tamergrlli/32S_BMS/docs/linkedin_square.png

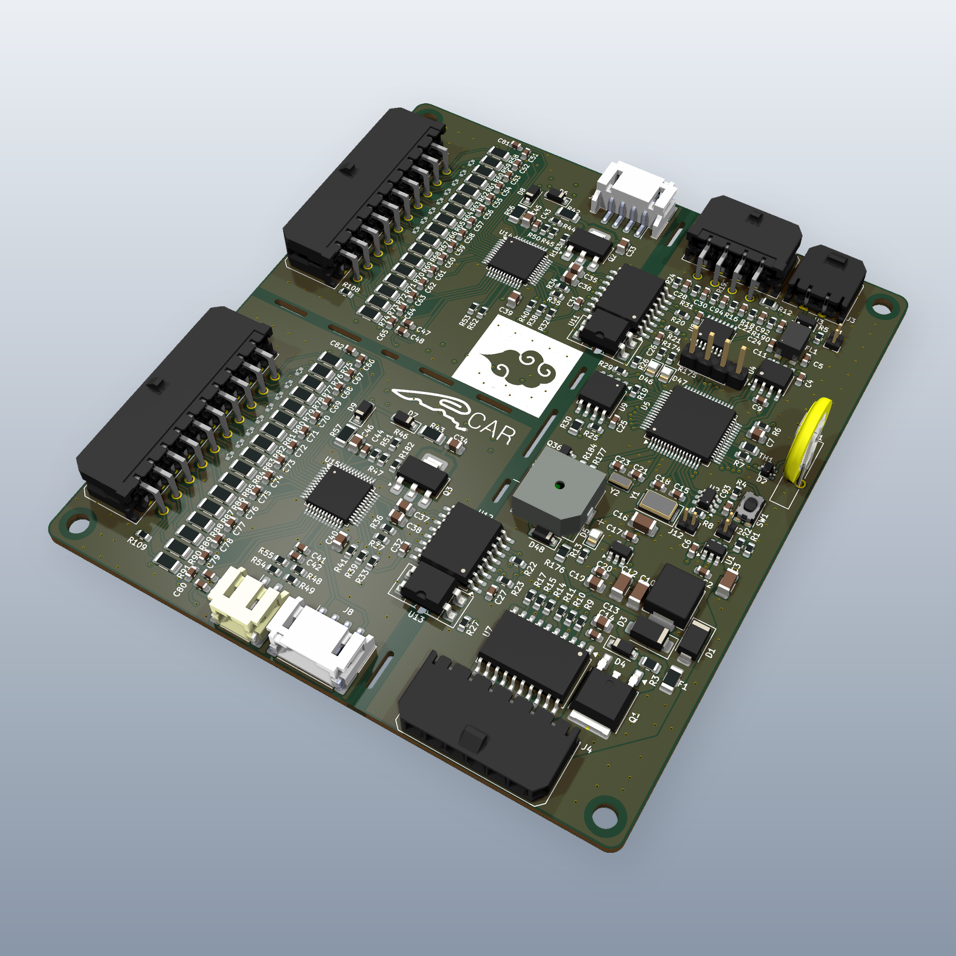
docs/linkedin_square.png
