tamergrlli/32S_BMS/32s_bms_lib/3dmodels/ACT45B_TDK.step

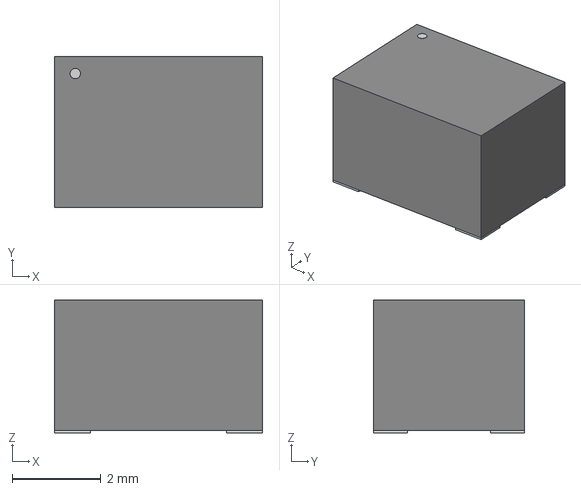
[picture p6: CAD file, 2026-11-05]
32s_bms_lib/3dmodels/ACT45B_TDK.step
4.70 x 3.40 x 3.00 mm
