tamergrlli/32S_BMS/32s_bms_lib/3dmodels/S2B-PH-SM4-TB.step

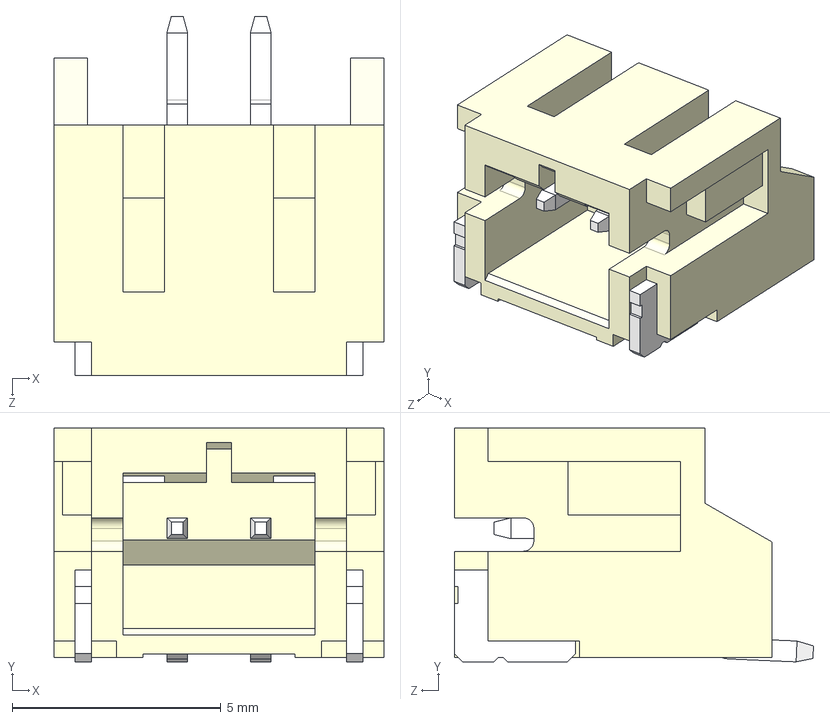
[picture p7: CAD file, 2026-11-05]
32s_bms_lib/3dmodels/S2B-PH-SM4-TB.step
7.90 x 5.60 x 8.60 mm
