tamergrlli/32S_BMS/32s_bms_lib/3dmodels/CR1220-VCN.stp

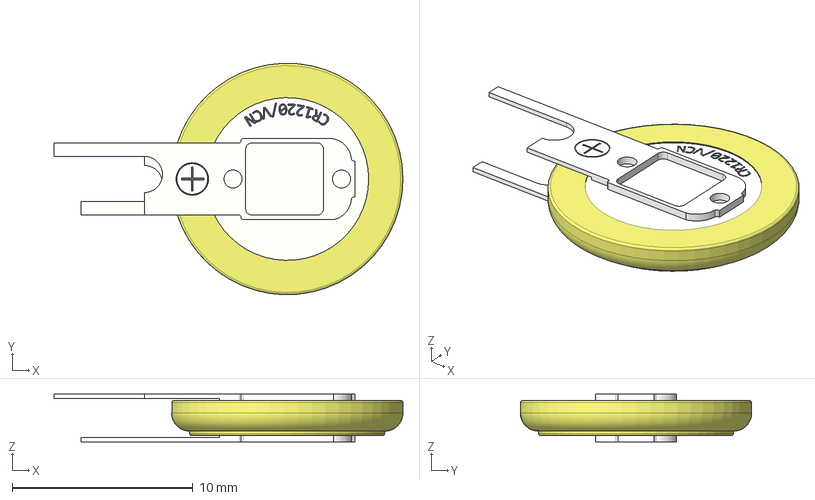
[picture p8: CAD file, 2026-11-05]
32s_bms_lib/3dmodels/CR1220-VCN.stp
19.3 x 12.8 x 2.65 mm
