tamergrlli/32S_BMS/32s_bms_lib/3dmodels/SMI-1027-T-5V-R.step

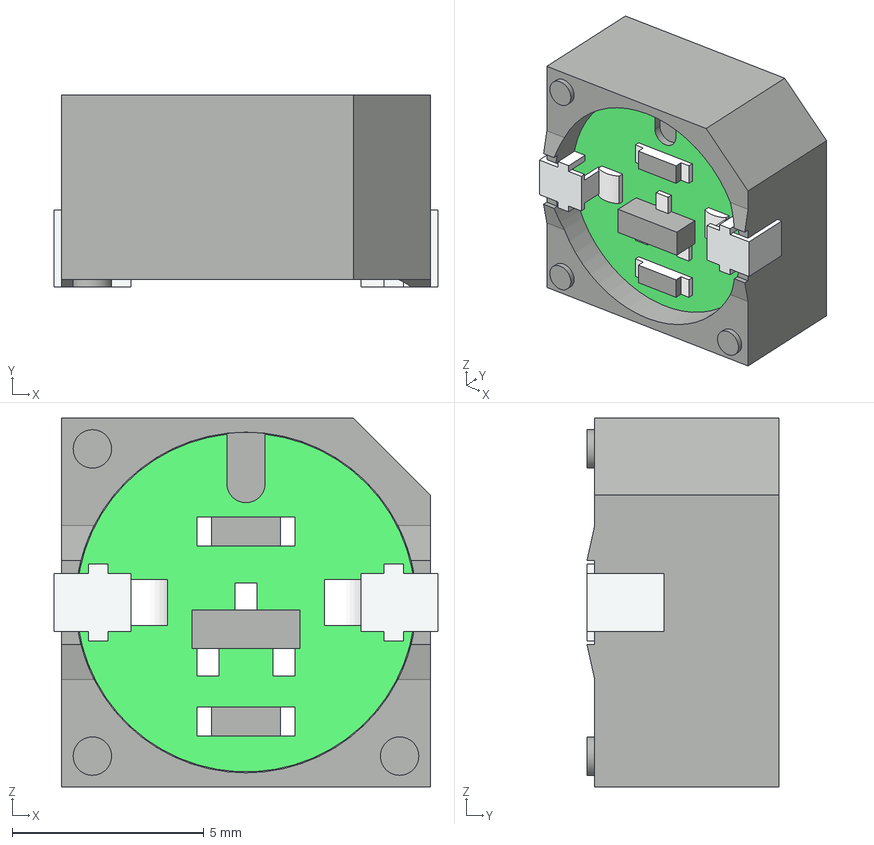
[picture p9: CAD file, 2026-11-05]
32s_bms_lib/3dmodels/SMI-1027-T-5V-R.step
10.0 x 5.00 x 9.60 mm
