tamergrlli/32S_BMS/32s_bms_lib/3dmodels/S4B-PH-SM4-TB.step

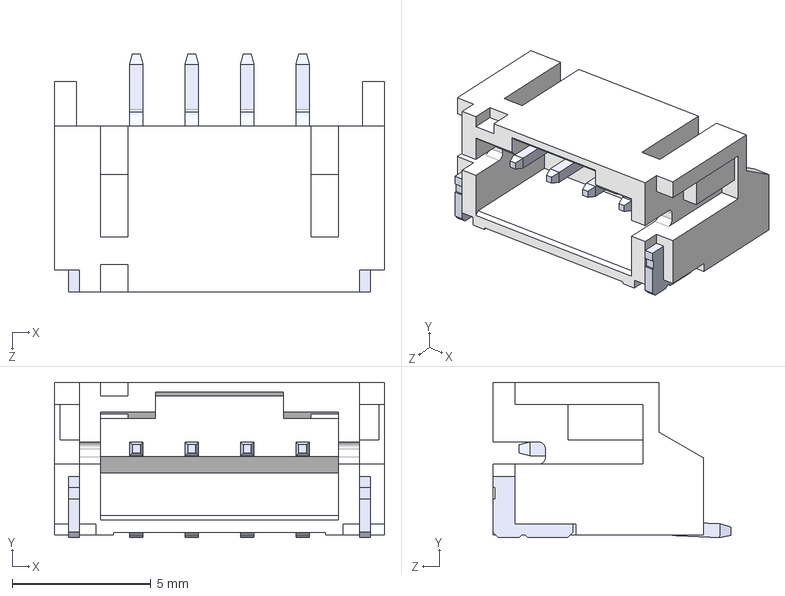
[picture p10: CAD file, 2026-11-05]
32s_bms_lib/3dmodels/S4B-PH-SM4-TB.step
11.9 x 5.60 x 8.60 mm
