tamergrlli/32S_BMS/32s_bms_lib/3dmodels/436501000.stp

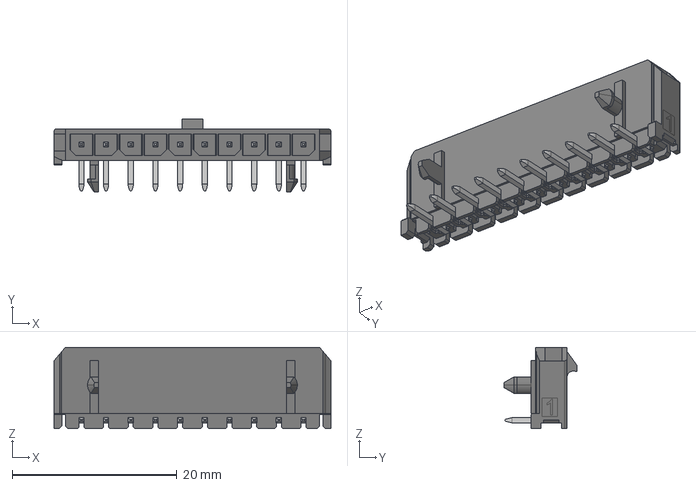
[picture p11: CAD file, 2026-11-05]
32s_bms_lib/3dmodels/436501000.stp
33.7 x 8.87 x 9.90 mm
