tamergrlli/32S_BMS/32s_bms_lib/3dmodels/436500600.stp

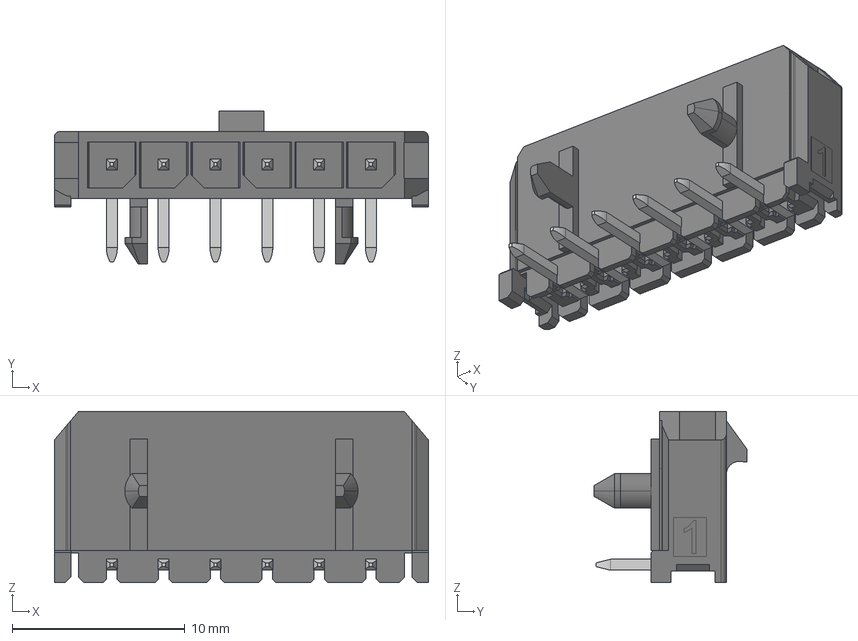
[picture p12: CAD file, 2026-11-05]
32s_bms_lib/3dmodels/436500600.stp
21.6 x 8.87 x 9.90 mm
