tamergrlli/32S_BMS/32s_bms_lib/3dmodels/430452000.stp

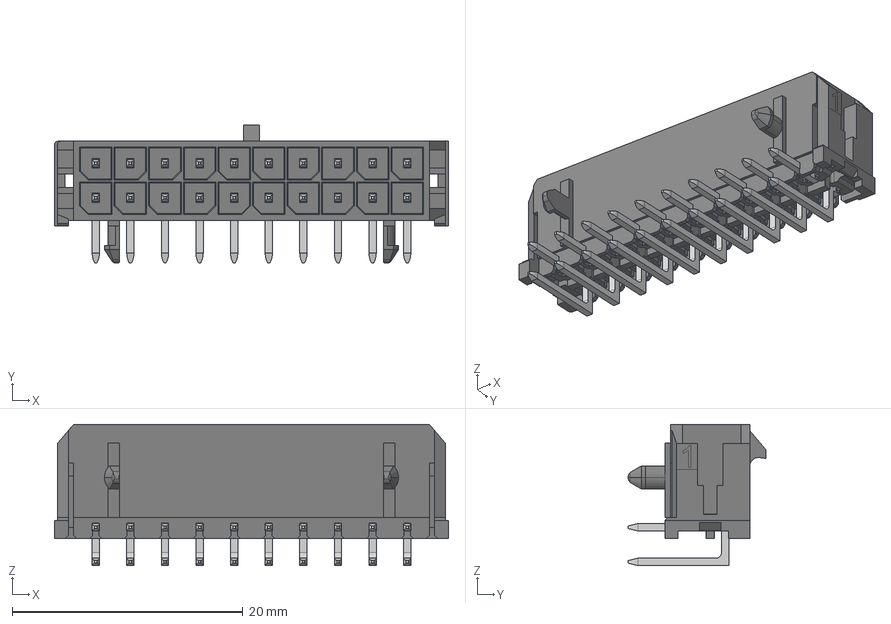
[picture p13: CAD file, 2026-11-05]
32s_bms_lib/3dmodels/430452000.stp
34.2 x 12.0 x 12.2 mm
