tamergrlli/32S_BMS/32s_bms_lib/3dmodels/430450800.stp

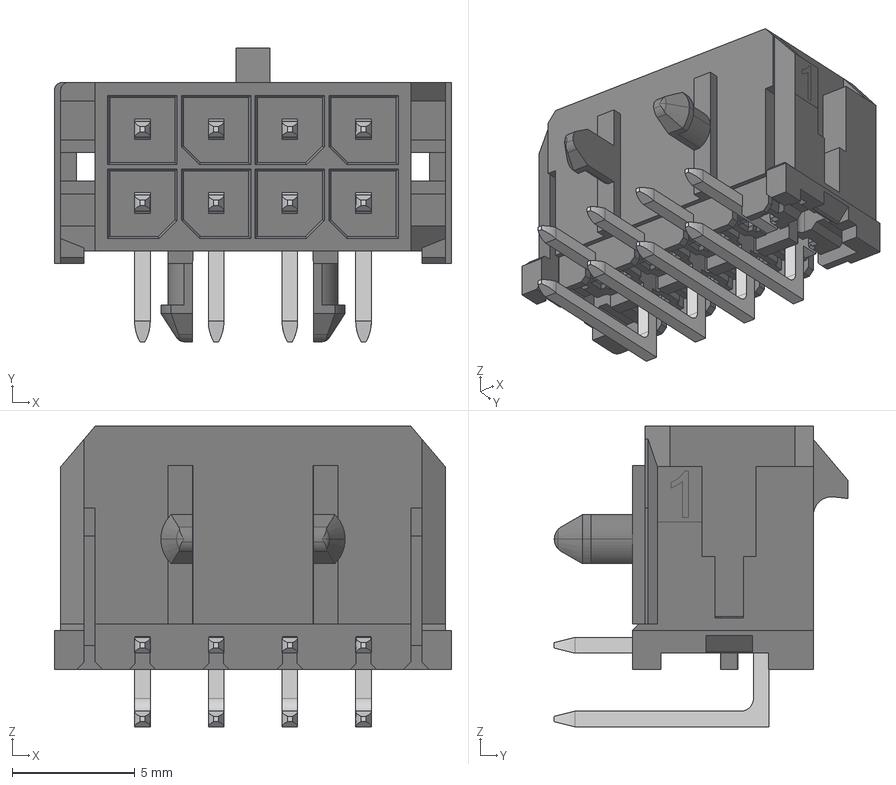
[picture p14: CAD file, 2026-11-05]
32s_bms_lib/3dmodels/430450800.stp
16.2 x 12.0 x 12.2 mm
