tamergrlli/32S_BMS/32s_bms_lib/3dmodels/436500200.stp

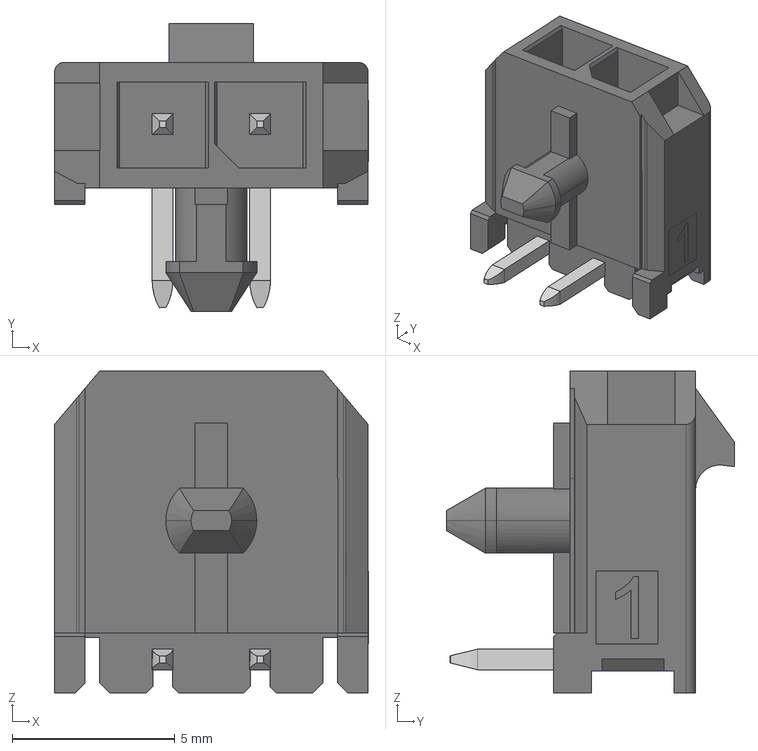
[picture p15: CAD file, 2026-11-05]
32s_bms_lib/3dmodels/436500200.stp
9.66 x 8.87 x 9.90 mm
