tamergrlli/32S_BMS/32s_bms/32s_bms.kicad_pcb

## KiCad design 32s_bms/32s_bms.kicad_pcb (2026-11-05)

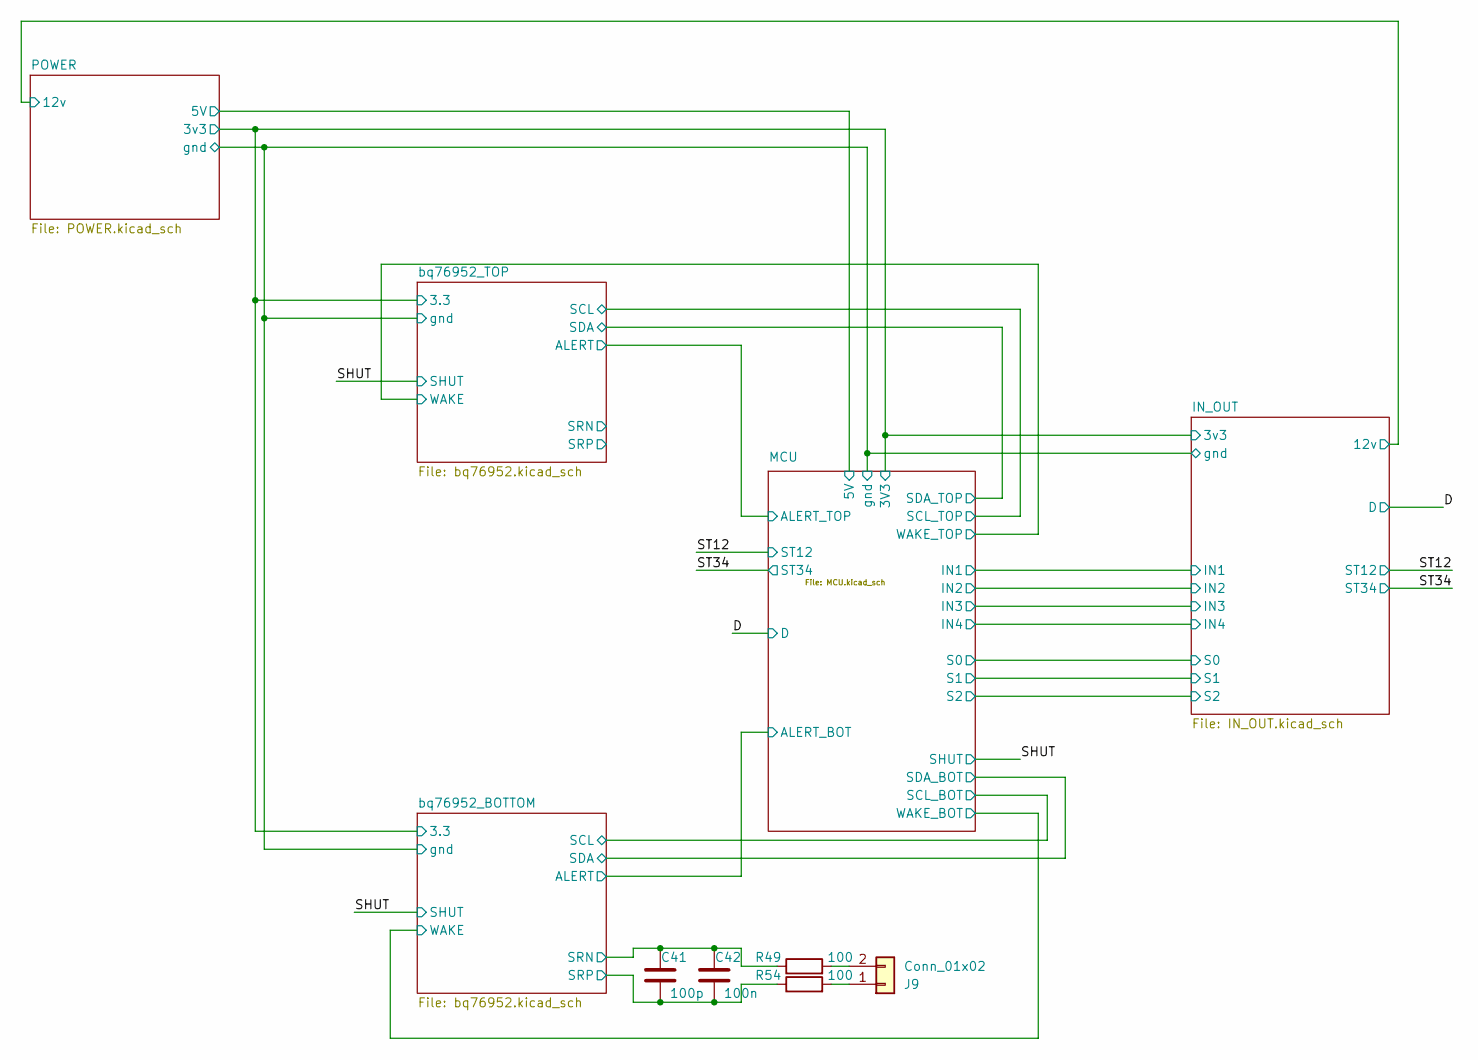
[picture p27: schematic 32s_bms.kicad_sch, 32S BMS]

Parts:
C41: 100p; C_0603_1608Metric
C42: 100n; C_0603_1608Metric
J9: Conn_01x02; JST_PH_S2B-PH-SM4-TB_1x02-1MP_P2.00mm_Horizontal
R49, R54: 100; R_0603_1608Metric

Connections:
/bq76952_BOTTOM/SRN: C41.2, C42.2, R49.1; also elsewhere on the board
/bq76952_BOTTOM/SRP: C41.1, C42.1, R54.1; also elsewhere on the board
unnamed: J9.1, R54.2
unnamed: J9.2, R49.2

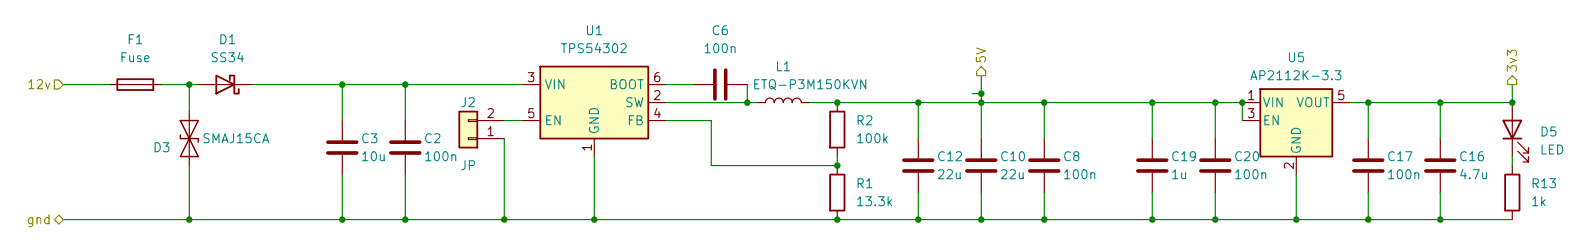
[picture p28: schematic POWER.kicad_sch]

Parts:
C2, C6, C8, C17, C20: 100n; C_0603_1608Metric
C3: 10u; C_1206_3216Metric
C10, C12: 22u; C_1206_3216Metric
C16: 4.7u; C_1206_3216Metric
C19: 1u; C_0805_2012Metric
D1: SS34; D_SMA
D3: SMAJ15CA; D_SMA
D5: LED; LED_0805_2012Metric
F1: Fuse; Fuse_1206_3216Metric
J2: JP; PinHeader_1x02_P1.27mm_Vertical
L1: ETQ-P3M150KVN; L_Panasonic_PCC-M0630M
R1: 13.3k; R_0603_1608Metric
R2: 100k; R_0603_1608Metric
R13: 1k; R_0603_1608Metric
U1: TPS54302; SOT-23-6
U5: AP2112K-3.3; SOT-23-5

Connections:
/IN_OUT/3v3: C16.1, C17.2, D5.2 (A), U5.5 (VOUT); also elsewhere on the board
/IN_OUT/12v: F1.1; also elsewhere on the board
/IN_OUT/gnd: C2.1, C3.2, C8.1, C10.2, C12.2, C16.2, C17.1, C19.2, C20.1, D3.2 (A2), J2.1, R1.2, R13.2, U1.1 (GND), U5.2 (GND); also elsewhere on the board
/MCU/5V: C8.2, C10.1, C12.1, C19.1, C20.2, L1.2, R2.1, U5.1 (VIN), U5.3 (EN); also elsewhere on the board
unnamed: D1.2 (A), D3.1 (A1), F1.2
unnamed: C2.2, C3.1, D1.1 (K), U1.3 (VIN)
unnamed: D5.1 (K), R13.1
unnamed: J2.2, U1.5 (EN)
unnamed: C6.1, U1.6 (BOOT)
unnamed: R1.1, R2.2, U1.4 (FB)
unnamed: C6.2, L1.1, U1.2 (SW)

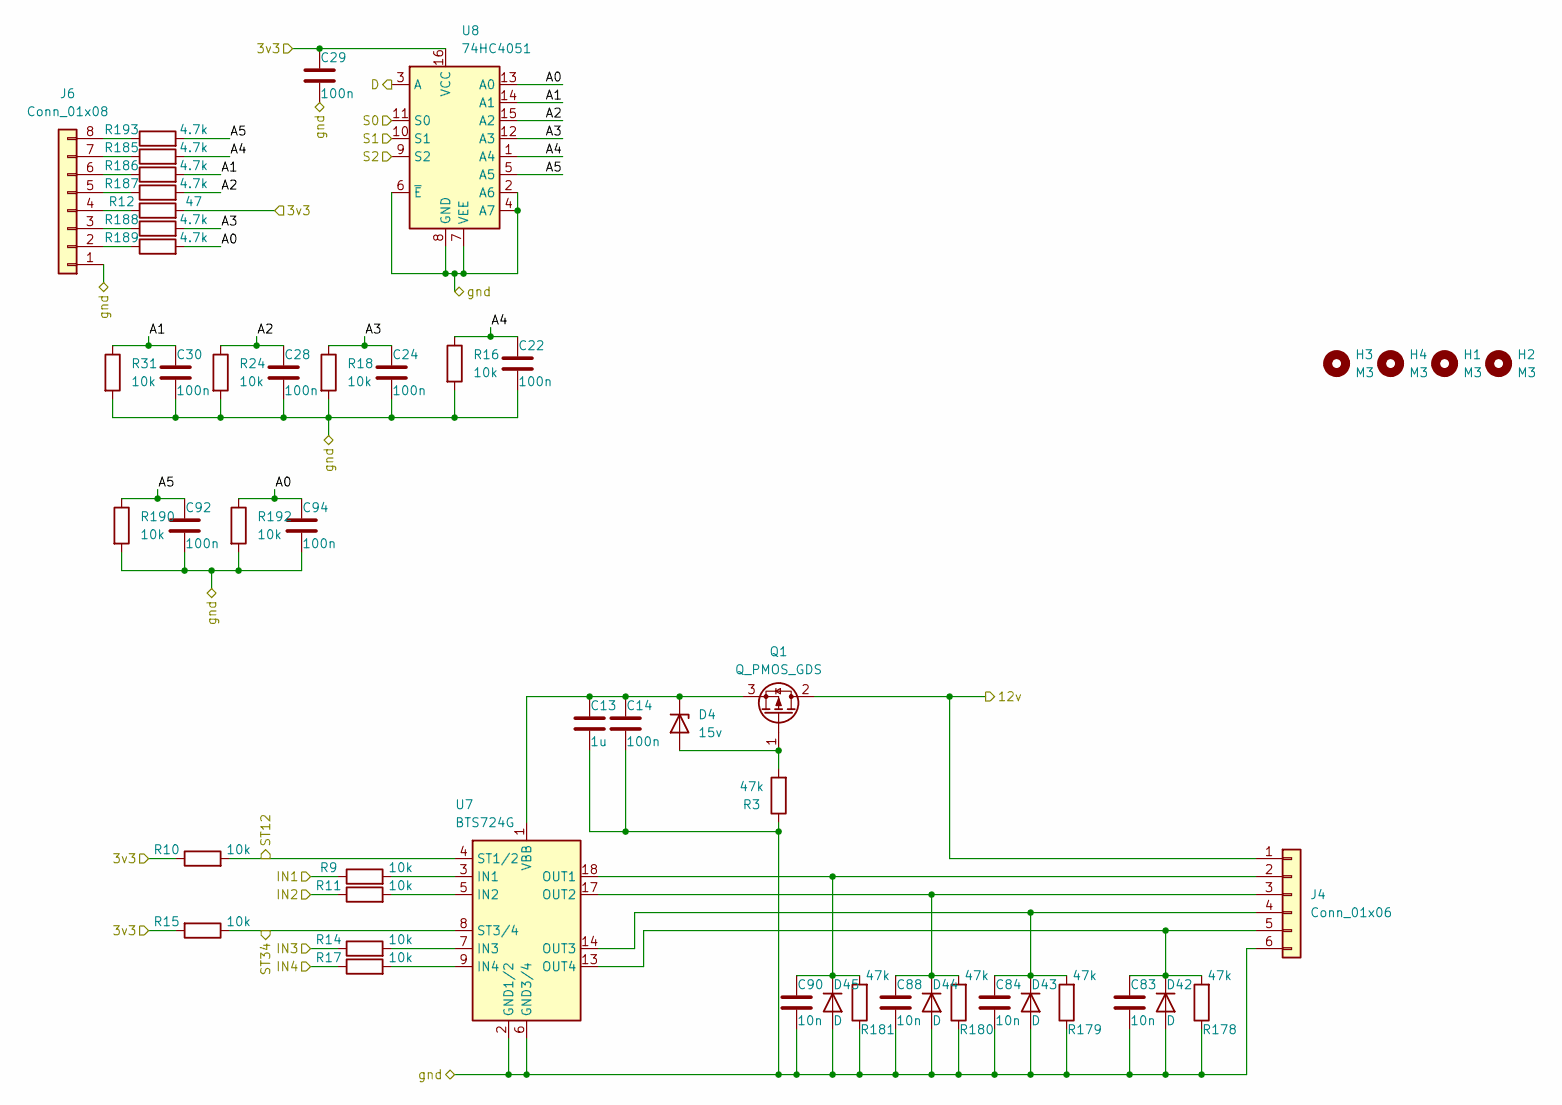
[picture p29: schematic IN_OUT.kicad_sch]

Parts:
C13: 1u; C_0805_2012Metric
C14, C22, C24, C28, C29, C30, C92, C94: 100n; C_0603_1608Metric
C83, C84, C88, C90: 10n; C_0805_2012Metric
D4: 15v; D_SOD-123
D42, D43, D44, D45: D; D_SOD-123
H1, H2, H3, H4: M3; MountingHole_3.2mm_M3
J4: Conn_01x06; Molex_Micro-Fit_3.0_43650-0600_1x06_P3.00mm_Horizontal
J6: Conn_01x08; Molex_Micro-Fit_3.0_43045-0800_2x04_P3.00mm_Horizontal
Q1: Q_PMOS_GDS; TO-252-2
R3, R178, R179, R180, R181: 47k; R_0805_2012Metric
R9, R10, R11, R14, R15, R16, R17, R18, R24, R31, R190, R192: 10k; R_0603_1608Metric
R12: 47; R_0805_2012Metric
R185, R186, R187, R188, R189, R193: 4.7k; R_0603_1608Metric
U7: BTS724G; Infineon_SOIC-20W_7.6x12.8mm_P1.27mm
U8: 74HC4051; TSSOP-16_4.4x5mm_P0.65mm

Connections:
/D: U8.3 (A); also elsewhere on the board
/IN_OUT/3v3: C29.1, R10.1, R12.2, R15.2, U8.16 (VCC); also elsewhere on the board
/IN_OUT/12v: J4.1, Q1.2 (D); also elsewhere on the board
/IN_OUT/A0: C94.1, R189.2, R192.1, U8.13 (A0)
/IN_OUT/A1: C30.1, R31.1, R186.2, U8.14 (A1)
/IN_OUT/A2: C28.1, R24.1, R187.2, U8.15 (A2)
/IN_OUT/A3: C24.1, R18.1, R188.2, U8.12 (A3)
/IN_OUT/A4: C22.1, R16.1, R185.2, U8.1 (A4)
/IN_OUT/A5: C92.1, R190.1, R193.2, U8.5 (A5)
/IN_OUT/IN1: R9.1; also elsewhere on the board
/IN_OUT/IN2: R11.1; also elsewhere on the board
/IN_OUT/IN3: R14.1; also elsewhere on the board
/IN_OUT/IN4: R17.1; also elsewhere on the board
/IN_OUT/S0: U8.11 (S0); also elsewhere on the board
/IN_OUT/S1: U8.10 (S1); also elsewhere on the board
/IN_OUT/S2: U8.9 (S2); also elsewhere on the board
/IN_OUT/gnd: C13.2, C14.2, C22.2, C24.2, C28.2, C29.2, C30.2, C83.2, C84.2, C88.2, C90.2, C92.2, C94.2, D42.2 (A), D43.2 (A), D44.2 (A), D45.2 (A), J4.6, J6.1, R3.1, R16.2, R18.2, R24.2, R31.2, R178.1, R179.1, R180.1, R181.1, R190.2, R192.2, U7.2 (GND1/2), U7.6 (GND3/4), U8.2 (A6), U8.4 (A7), U8.6 (~E), U8.7 (VEE), U8.8 (GND); also elsewhere on the board
/ST12: R10.2, U7.4 (ST1/2); also elsewhere on the board
/ST34: R15.1, U7.8 (ST3/4); also elsewhere on the board
unnamed: D4.2 (A), Q1.1 (G), R3.2
unnamed: C13.1, C14.1, D4.1 (K), Q1.3 (S), U7.1 (VBB), U7.10 (VBB), U7.11 (VBB), U7.12 (VBB), U7.15 (VBB), U7.16 (VBB), U7.19 (VBB), U7.20 (VBB)
unnamed: C83.1, D42.1 (K), J4.5, R178.2, U7.13 (OUT4)
unnamed: C84.1, D43.1 (K), J4.4, R179.2, U7.14 (OUT3)
unnamed: C88.1, D44.1 (K), J4.3, R180.2, U7.17 (OUT2)
unnamed: C90.1, D45.1 (K), J4.2, R181.2, U7.18 (OUT1)
unnamed: J6.2, R189.1
unnamed: J6.3, R188.1
unnamed: J6.4, R12.1
unnamed: J6.5, R187.1
unnamed: J6.6, R186.1
unnamed: J6.7, R185.1
unnamed: J6.8, R193.1
unnamed: R9.2, U7.3 (IN1)
unnamed: R11.2, U7.5 (IN2)
unnamed: R14.2, U7.7 (IN3)
unnamed: R17.2, U7.9 (IN4)

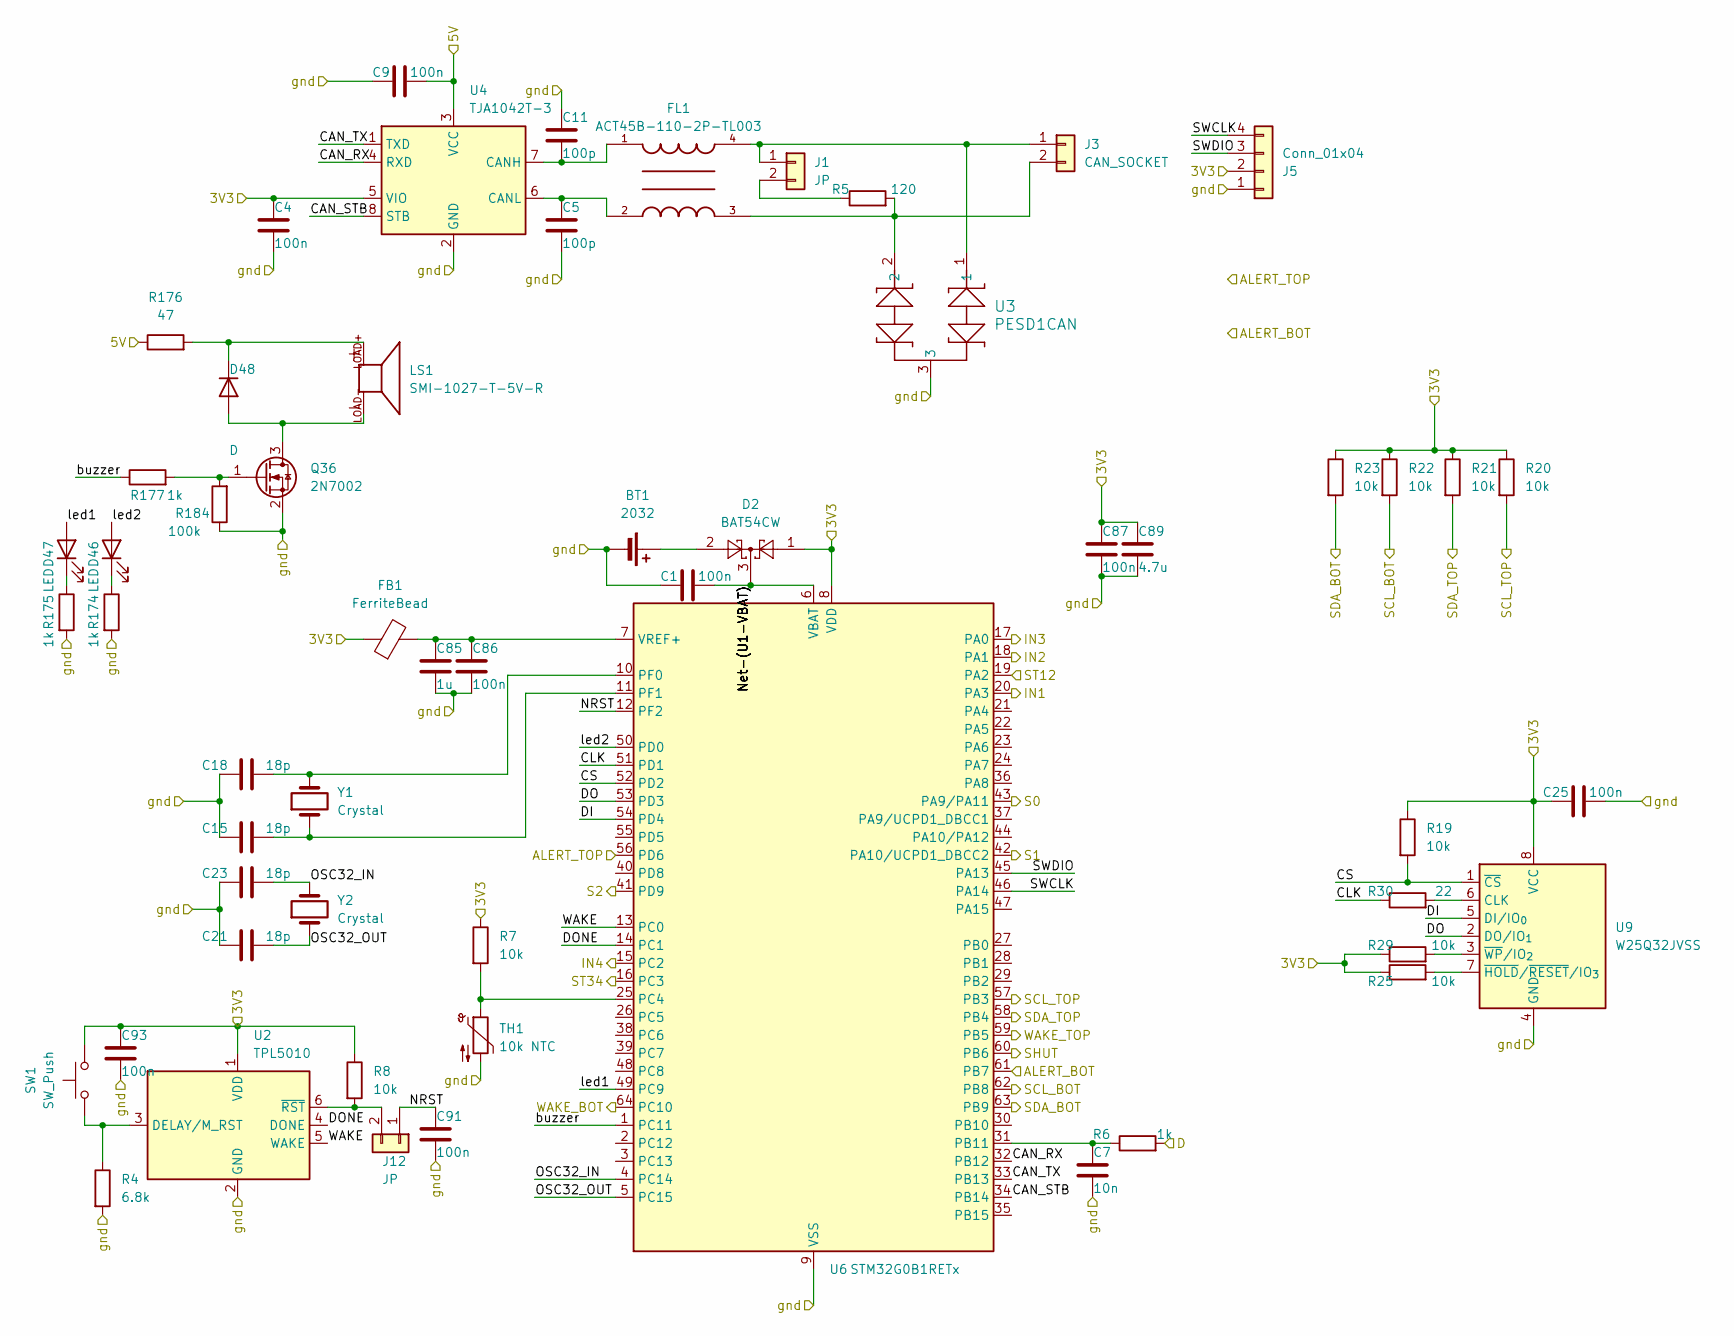
[picture p30: schematic MCU.kicad_sch]

Parts:
BT1: 2032; Battery_Panasonic_CR1220-VCN_Vertical_CircularHoles
C1, C4, C9, C25, C86, C87, C91, C93: 100n; C_0603_1608Metric
C5, C11: 100p; C_0603_1608Metric
C7: 10n; C_0805_2012Metric
C15, C18, C21, C23: 18p; C_0603_1608Metric
C85: 1u; C_0805_2012Metric
C89: 4.7u; C_1206_3216Metric
D2: BAT54CW; SOT-323_SC-70
D46, D47: LED; LED_0805_2012Metric
D48: D; D_SOD-123
FB1: FerriteBead; L_0603_1608Metric
FL1: ACT45B-110-2P-TL003; PARTREV 20200405
J1, J12: JP; PinHeader_1x02_P1.27mm_Vertical
J3: CAN_SOCKET; Molex_Micro-Fit_3.0_43650-0200_1x02_P3.00mm_Horizontal
J5: Conn_01x04; PinHeader_1x04_P2.54mm_Vertical
LS1: SMI-1027-T-5V-R; XDCR_SMI-1027-T-5V-R; PARTREV 03/26/2020; DigiKey_Part_Number 668-SMI-1027-T-5V-RCT-ND
Q36: 2N7002; SOT-23
R4: 6.8k; R_0603_1608Metric
R5: 120; R_0603_1608Metric
R6, R174, R175, R177: 1k; R_0603_1608Metric
R7, R8, R19, R20, R21, R22, R23, R25, R29: 10k; R_0603_1608Metric
R30: 22; R_0805_2012Metric
R176: 47; R_0805_2012Metric
R184: 100k; R_0603_1608Metric
SW1: SW_Push; SW_Push_1P1T_NO_CK_KMR2
TH1: 10k NTC; R_0805_2012Metric
U2: TPL5010; SOT-23-6
U3: PESD1CAN; SOT23_NXP
U4: TJA1042T-3; SOIC-8_3.9x4.9mm_P1.27mm
U6: STM32G0B1RETx; LQFP-64_10x10mm_P0.5mm
U9: W25Q32JVSS; SOIC-8_5.3x5.3mm_P1.27mm
Y1: Crystal; Crystal_SMD_5032-2Pin_5.0x3.2mm
Y2: Crystal; Crystal_SMD_3215-2Pin_3.2x1.5mm

Connections:
/D: R6.2; also elsewhere on the board
/IN_OUT/3v3: C4.1, C25.1, C87.1, C89.1, C93.1, D2.1, FB1.1, J5.2, R7.1, R8.1, R19.1, R20.1, R21.1, R22.1, R23.1, R25.1, R29.1, SW1.2, U2.1 (VDD), U4.5 (VIO), U6.8 (VDD), U9.8 (VCC); also elsewhere on the board
/IN_OUT/IN1: U6.20 (PA3); also elsewhere on the board
/IN_OUT/IN2: U6.18 (PA1); also elsewhere on the board
/IN_OUT/IN3: U6.17 (PA0); also elsewhere on the board
/IN_OUT/IN4: U6.15 (PC2); also elsewhere on the board
/IN_OUT/S0: U6.43 (PA9/PA11); also elsewhere on the board
/IN_OUT/S1: U6.42 (PA10/UCPD1_DBCC2); also elsewhere on the board
/IN_OUT/S2: U6.41 (PD9); also elsewhere on the board
/IN_OUT/gnd: BT1.2 (-), C1.1, C4.2, C5.2, C7.2, C9.1, C11.1, C15.1, C18.1, C21.1, C23.1, C25.2, C85.2, C86.2, C87.2, C89.2, C91.2, C93.2, J5.1, Q36.2 (S), R4.2, R174.2, R175.2, R184.1, TH1.2, U2.2 (GND), U3.3, U4.2 (GND), U6.9 (VSS), U9.4 (GND); also elsewhere on the board
/MCU/5V: C9.2, R176.1, U4.3 (VCC); also elsewhere on the board
/MCU/ALERT_BOT: U6.61 (PB7); also elsewhere on the board
/MCU/ALERT_TOP: U6.56 (PD6); also elsewhere on the board
/MCU/CAN_RX: U4.4 (RXD), U6.32 (PB12)
/MCU/CAN_STB: U4.8 (STB), U6.34 (PB14)
/MCU/CAN_TX: U4.1 (TXD), U6.33 (PB13)
/MCU/CLK: R30.1, U6.51 (PD1)
/MCU/CS: R19.2, U6.52 (PD2), U9.1 (~CS)
/MCU/DI: U6.54 (PD4), U9.5 (DI/IO_{0})
/MCU/DO: U6.53 (PD3), U9.2 (DO/IO_{1})
/MCU/DONE: U2.4 (DONE), U6.14 (PC1)
/MCU/NRST: C91.1, J12.1, U6.12 (PF2)
/MCU/Net-(U1-VBAT): C1.2, D2.3, U6.6 (VBAT)
/MCU/OSC32_IN: C23.2, U6.4 (PC14), Y2.2
/MCU/OSC32_OUT: C21.2, U6.5 (PC15), Y2.1
/MCU/SCL_BOT: R22.2, U6.62 (PB8); also elsewhere on the board
/MCU/SCL_TOP: R20.2, U6.57 (PB3); also elsewhere on the board
/MCU/SDA_BOT: R23.2, U6.63 (PB9); also elsewhere on the board
/MCU/SDA_TOP: R21.2, U6.58 (PB4); also elsewhere on the board
/MCU/SWCLK: J5.4, U6.46 (PA14)
/MCU/SWDIO: J5.3, U6.45 (PA13)
/MCU/WAKE: U2.5 (WAKE), U6.13 (PC0)
/MCU/WAKE_BOT: U6.64 (PC10); also elsewhere on the board
/MCU/WAKE_TOP: U6.59 (PB5); also elsewhere on the board
/MCU/buzzer: R177.1, U6.1 (PC11)
/MCU/led1: D47.2 (A), U6.49 (PC9)
/MCU/led2: D46.2 (A), U6.50 (PD0)
/SHUT: U6.60 (PB6); also elsewhere on the board
/ST12: U6.19 (PA2); also elsewhere on the board
/ST34: U6.16 (PC3); also elsewhere on the board
unnamed: BT1.1 (+), D2.2
unnamed: D46.1 (K), R174.1
unnamed: D47.1 (K), R175.1
unnamed: D48.2 (A), LS1.LOAD-, Q36.3 (D)
unnamed: D48.1 (K), LS1.LOAD+, R176.2
unnamed: FL1.4, J1.1, J3.1, U3.1
unnamed: J1.2, R5.1
unnamed: FL1.3, J3.2, R5.2, U3.2
unnamed: J12.2, R8.2, U2.6 (~RST)
unnamed: Q36.1 (G), R177.2, R184.2
unnamed: R4.1, SW1.1, U2.3 (DELAY/M_RST)
unnamed: C11.2, FL1.1, U4.7 (CANH)
unnamed: C5.1, FL1.2, U4.6 (CANL)
unnamed: C7.1, R6.1, U6.31 (PB11)
unnamed: R7.2, TH1.1, U6.25 (PC4)
unnamed: C18.2, U6.10 (PF0), Y1.2
unnamed: C15.2, U6.11 (PF1), Y1.1
unnamed: C85.1, C86.1, FB1.2, U6.7 (VREF+)
unnamed: R30.2, U9.6 (CLK)
unnamed: R25.2, U9.7 (~HOLD/~RESET/IO_{3})
unnamed: R29.2, U9.3 (~WP/IO_{2})

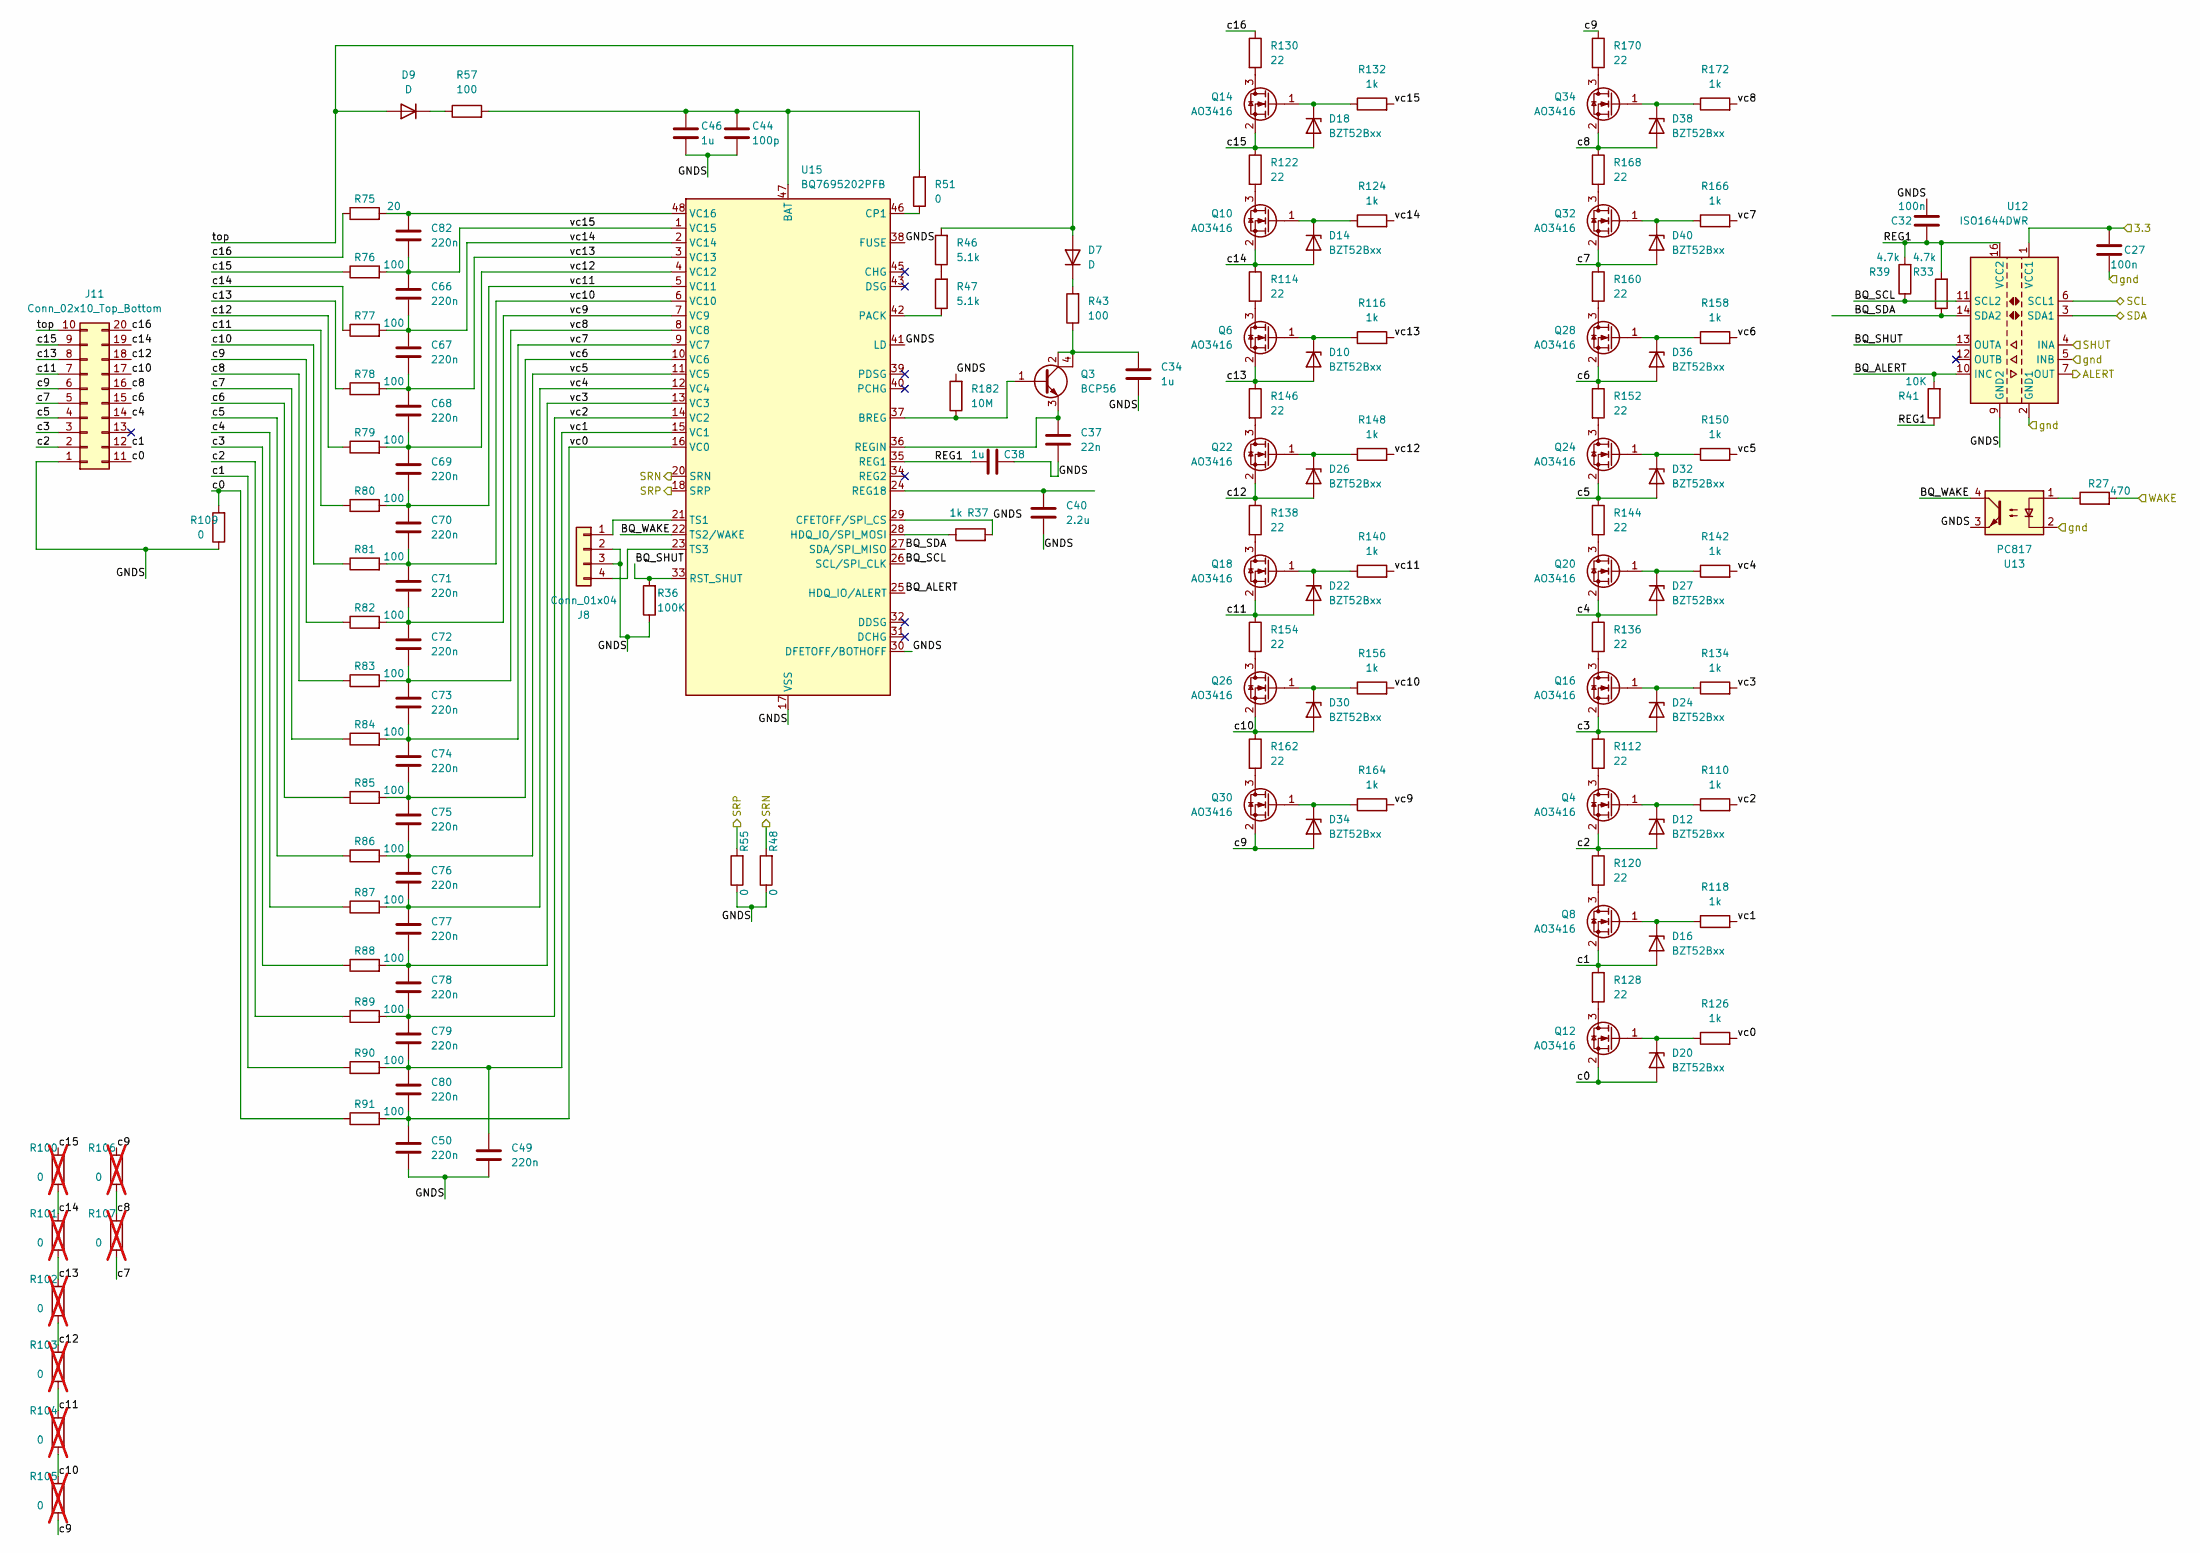
[picture p31: schematic bq76952.kicad_sch]

Parts:
C27, C32: 100n; C_0603_1608Metric
C34, C38, C46: 1u; C_0805_2012Metric
C37: 22n; C_0805_2012Metric
C40: 2.2u; C_0805_2012Metric
C44: 100p; C_0603_1608Metric
C49, C50, C66, C67, C68, C69, C70, C71, C72, C73, C74, C75, C76, C77, C78, C79, C80, C82: 220n; C_0603_1608Metric
D7, D9: D; D_SOD-123
D10, D12, D14, D16, D18, D20, D22, D24, D26, D27, D30, D32, D34, D36, D38, D40: BZT52Bxx; D_SOD-123F
J8: Conn_01x04; JST_PH_S4B-PH-SM4-TB_1x04-1MP_P2.00mm_Horizontal
J11: Conn_02x10_Top_Bottom; Molex_Micro-Fit_3.0_43045-2000_2x10_P3.00mm_Horizontal
Q3: BCP56; SOT-223
Q4, Q6, Q8, Q10, Q12, Q14, Q16, Q18, Q20, Q22, Q24, Q26, Q28, Q30, Q32, Q34: AO3416; SOT-23
R27: 470; R_0603_1608Metric
R33, R39: 4.7k; R_0603_1608Metric
R36: 100K; R_0603_1608Metric
R37, R110, R116, R118, R124, R126, R132, R134, R140, R142, R148, R150, R156, R158, R164, R166, R172: 1k; R_0603_1608Metric
R41: 10K; R_0603_1608Metric
R43, R57, R76, R77, R78, R79, R80, R81, R82, R83, R84, R85, R86, R87, R88, R89, R90, R91: 100; R_1206_3216Metric
R46, R47: 5.1k; R_0603_1608Metric
R48, R51, R55, R109: 0; R_0603_1608Metric
R75: 20; R_1206_3216Metric
R100, R101, R102, R103, R104, R105, R106, R107: 0; R_0402_1005Metric; not fitted
R112, R114, R120, R122, R128, R130, R136, R138, R144, R146, R152, R154, R160, R162, R168, R170: 22; R_2512_6332Metric
R182: 10M; R_0603_1608Metric
U12: ISO1644DWR; SOIC-16W_7.5x10.3mm_P1.27mm
U13: PC817; DIP-4_W7.62mm_SMDSocket_SmallPads
U15: BQ7695202PFB; TQFP-48_7x7mm_P0.5mm

Connections:
/IN_OUT/3v3: C27.2, U12.1 (VCC1); also elsewhere on the board
/IN_OUT/gnd: C27.1, U12.2 (GND1), U12.5 (INB), U12.8 (GND1), U13.2; also elsewhere on the board
/MCU/ALERT_BOT: U12.7 (OUT); also elsewhere on the board
/MCU/SCL_BOT: U12.6 (SCL1); also elsewhere on the board
/MCU/SDA_BOT: U12.3 (SDA1); also elsewhere on the board
/MCU/WAKE_BOT: R27.2; also elsewhere on the board
/SHUT: U12.4 (INA); also elsewhere on the board
/bq76952_BOTTOM/BQ_ALERT: R41.2, U12.10 (INC), U15.25 (HDQ_IO/ALERT)
/bq76952_BOTTOM/BQ_SCL: R39.1, U12.11 (SCL2), U15.26 (SCL/SPI_CLK)
/bq76952_BOTTOM/BQ_SDA: R33.1, U12.14 (SDA2), U15.27 (SDA/SPI_MISO)
/bq76952_BOTTOM/BQ_SHUT: R36.2, U12.13 (OUTA), U15.33 (RST_SHUT)
/bq76952_BOTTOM/BQ_WAKE: U13.4, U15.22 (TS2/WAKE)
/bq76952_BOTTOM/GNDS: C32.1, C34.2, C37.2, C38.2, C40.2, C44.2, C46.2, C49.2, C50.2, J8.2, J8.3, J11.1, R36.1, R37.2, R48.1, R55.1, R109.1, R182.2, U12.9 (GND2), U12.15 (GND2), U13.3, U15.17 (VSS), U15.29 (CFETOFF/SPI_CS), U15.30 (DFETOFF/BOTHOFF), U15.38 (FUSE), U15.41 (LD)
/bq76952_BOTTOM/REG1: C32.2, C38.1, R33.2, R39.2, R41.1, U12.16 (VCC2), U15.35 (REG1)
/bq76952_BOTTOM/SRN: R48.2, U15.20 (SRN); also elsewhere on the board
/bq76952_BOTTOM/SRP: R55.2, U15.18 (SRP); also elsewhere on the board
/bq76952_BOTTOM/c0: D20.2 (A), J11.11, Q12.2 (S), R91.1, R109.2
/bq76952_BOTTOM/c1: D16.2 (A), J11.12, Q8.2 (S), R90.1, R128.1
/bq76952_BOTTOM/c2: D12.2 (A), J11.2, Q4.2 (S), R89.1, R120.1
/bq76952_BOTTOM/c3: D24.2 (A), J11.3, Q16.2 (S), R88.1, R112.1
/bq76952_BOTTOM/c4: D27.2 (A), J11.14, Q20.2 (S), R87.1, R136.1
/bq76952_BOTTOM/c5: D32.2 (A), J11.4, Q24.2 (S), R86.1, R144.1
/bq76952_BOTTOM/c6: D36.2 (A), J11.15, Q28.2 (S), R85.1, R152.1
/bq76952_BOTTOM/c7: D40.2 (A), J11.5, Q32.2 (S), R84.1, R107.1, R160.1
/bq76952_BOTTOM/c8: D38.2 (A), J11.16, Q34.2 (S), R83.1, R106.1, R107.2, R168.1
/bq76952_BOTTOM/c9: D34.2 (A), J11.6, Q30.2 (S), R82.1, R105.1, R106.2, R170.1
/bq76952_BOTTOM/c10: D30.2 (A), J11.17, Q26.2 (S), R81.1, R104.1, R105.2, R162.1
/bq76952_BOTTOM/c11: D22.2 (A), J11.7, Q18.2 (S), R80.1, R103.1, R104.2, R154.1
/bq76952_BOTTOM/c12: D26.2 (A), J11.18, Q22.2 (S), R79.1, R102.1, R103.2, R138.1
/bq76952_BOTTOM/c13: D10.2 (A), J11.8, Q6.2 (S), R78.1, R101.1, R102.2, R146.1
/bq76952_BOTTOM/c14: D14.2 (A), J11.19, Q10.2 (S), R77.1, R100.1, R101.2, R114.1
/bq76952_BOTTOM/c15: D18.2 (A), J11.9, Q14.2 (S), R76.1, R100.2, R122.1
/bq76952_BOTTOM/c16: J11.20, R75.1, R130.1
/bq76952_BOTTOM/top: D7.2 (A), D9.2 (A), J11.10, R46.2
/bq76952_BOTTOM/vc0: C50.1, C80.2, R91.2, R126.2, U15.16 (VC0)
/bq76952_BOTTOM/vc1: C49.1, C79.2, C80.1, R90.2, R118.2, U15.15 (VC1)
/bq76952_BOTTOM/vc2: C78.2, C79.1, R89.2, R110.2, U15.14 (VC2)
/bq76952_BOTTOM/vc3: C77.2, C78.1, R88.2, R134.2, U15.13 (VC3)
/bq76952_BOTTOM/vc4: C76.2, C77.1, R87.2, R142.2, U15.12 (VC4)
/bq76952_BOTTOM/vc5: C75.2, C76.1, R86.2, R150.2, U15.11 (VC5)
/bq76952_BOTTOM/vc6: C74.2, C75.1, R85.2, R158.2, U15.10 (VC6)
/bq76952_BOTTOM/vc7: C73.2, C74.1, R84.2, R166.2, U15.9 (VC7)
/bq76952_BOTTOM/vc8: C72.2, C73.1, R83.2, R172.2, U15.8 (VC8)
/bq76952_BOTTOM/vc9: C71.2, C72.1, R82.2, R164.2, U15.7 (VC9)
/bq76952_BOTTOM/vc10: C70.2, C71.1, R81.2, R156.2, U15.6 (VC10)
/bq76952_BOTTOM/vc11: C69.2, C70.1, R80.2, R140.2, U15.5 (VC11)
/bq76952_BOTTOM/vc12: C68.2, C69.1, R79.2, R148.2, U15.4 (VC12)
/bq76952_BOTTOM/vc13: C67.2, C68.1, R78.2, R116.2, U15.3 (VC13)
/bq76952_BOTTOM/vc14: C66.2, C67.1, R77.2, R124.2, U15.2 (VC14)
/bq76952_BOTTOM/vc15: C66.1, C82.2, R76.2, R132.2, U15.1 (VC15)
unnamed: C34.1, Q3.2 (C), Q3.4 (C), R43.1
unnamed: D7.1 (K), R43.2
unnamed: D9.1 (K), R57.1
unnamed: D10.1 (K), Q6.1 (G), R116.1
unnamed: D12.1 (K), Q4.1 (G), R110.1
unnamed: D14.1 (K), Q10.1 (G), R124.1
unnamed: D16.1 (K), Q8.1 (G), R118.1
unnamed: D18.1 (K), Q14.1 (G), R132.1
unnamed: D20.1 (K), Q12.1 (G), R126.1
unnamed: D22.1 (K), Q18.1 (G), R140.1
unnamed: D24.1 (K), Q16.1 (G), R134.1
unnamed: D26.1 (K), Q22.1 (G), R148.1
unnamed: D27.1 (K), Q20.1 (G), R142.1
unnamed: D30.1 (K), Q26.1 (G), R156.1
unnamed: D32.1 (K), Q24.1 (G), R150.1
unnamed: D34.1 (K), Q30.1 (G), R164.1
unnamed: D36.1 (K), Q28.1 (G), R158.1
unnamed: D38.1 (K), Q34.1 (G), R172.1
unnamed: D40.1 (K), Q32.1 (G), R166.1
unnamed: J8.1, U15.21 (TS1)
unnamed: J8.4, U15.23 (TS3)
unnamed: Q3.1 (B), R182.1, U15.37 (BREG)
unnamed: C37.1, Q3.3 (E), U15.36 (REGIN)
unnamed: Q4.3 (D), R112.2
unnamed: Q6.3 (D), R114.2
unnamed: Q8.3 (D), R120.2
unnamed: Q10.3 (D), R122.2
unnamed: Q12.3 (D), R128.2
unnamed: Q14.3 (D), R130.2
unnamed: Q16.3 (D), R136.2
unnamed: Q18.3 (D), R138.2
unnamed: Q20.3 (D), R144.2
unnamed: Q22.3 (D), R146.2
unnamed: Q24.3 (D), R152.2
unnamed: Q26.3 (D), R154.2
unnamed: Q28.3 (D), R160.2
unnamed: Q30.3 (D), R162.2
unnamed: Q32.3 (D), R168.2
unnamed: Q34.3 (D), R170.2
unnamed: R27.1, U13.1
unnamed: R46.1, R47.2
unnamed: C44.1, C46.1, R51.2, R57.2, U15.47 (BAT)
unnamed: R51.1, U15.46 (CP1)
unnamed: R37.1, U15.28 (HDQ_IO/SPI_MOSI)
unnamed: R47.1, U15.42 (PACK)
unnamed: C40.1, U15.24 (REG18)
unnamed: C82.1, R75.2, U15.48 (VC16)

Parts of its further copies:
C26, C31: 100n; C_0603_1608Metric
C33, C36, C45: 1u; C_0805_2012Metric
C35: 22n; C_0805_2012Metric
C39: 2.2u; C_0805_2012Metric
C43: 100p; C_0603_1608Metric
C47, C48, C51, C52, C53, C54, C55, C56, C57, C58, C59, C60, C61, C62, C63, C64, C65, C81: 220n; C_0603_1608Metric
D6, D8: D; D_SOD-123
D11, D13, D15, D17, D19, D21, D23, D25, D28, D29, D31, D33, D35, D37, D39, D41: BZT52Bxx; D_SOD-123F
J7: Conn_01x04; JST_PH_S4B-PH-SM4-TB_1x04-1MP_P2.00mm_Horizontal
J10: Conn_02x10_Top_Bottom; Molex_Micro-Fit_3.0_43045-2000_2x10_P3.00mm_Horizontal
Q2: BCP56; SOT-223
Q5, Q7, Q9, Q11, Q13, Q15, Q17, Q19, Q21, Q23, Q25, Q27, Q29, Q31, Q33, Q35: AO3416; SOT-23
R26: 470; R_0603_1608Metric
R32, R38: 4.7k; R_0603_1608Metric
R34: 100K; R_0603_1608Metric
R35, R111, R117, R119, R125, R127, R133, R135, R141, R143, R149, R151, R157, R159, R165, R167, R173: 1k; R_0603_1608Metric
R40: 10K; R_0603_1608Metric
R42, R56, R59, R60, R61, R62, R63, R64, R65, R66, R67, R68, R69, R70, R71, R72, R73, R74: 100; R_1206_3216Metric
R44, R45: 5.1k; R_0603_1608Metric
R50, R52, R53, R108: 0; R_0603_1608Metric
R58: 20; R_1206_3216Metric
R92, R93, R94, R95, R96, R97, R98, R99: 0; R_0402_1005Metric; not fitted
R113, R115, R121, R123, R129, R131, R137, R139, R145, R147, R153, R155, R161, R163, R169, R171: 22; R_2512_6332Metric
R183: 10M; R_0603_1608Metric
U10: ISO1644DWR; SOIC-16W_7.5x10.3mm_P1.27mm
U11: PC817; DIP-4_W7.62mm_SMDSocket_SmallPads
U14: BQ7695202PFB; TQFP-48_7x7mm_P0.5mm

Connections of its further copies:
/IN_OUT/3v3: C26.2, U10.1 (VCC1); also elsewhere on the board
/IN_OUT/gnd: C26.1, U10.2 (GND1), U10.5 (INB), U10.8 (GND1), U11.2; also elsewhere on the board
/MCU/ALERT_TOP: U10.7 (OUT); also elsewhere on the board
/MCU/SCL_TOP: U10.6 (SCL1); also elsewhere on the board
/MCU/SDA_TOP: U10.3 (SDA1); also elsewhere on the board
/MCU/WAKE_TOP: R26.2; also elsewhere on the board
/SHUT: U10.4 (INA); also elsewhere on the board
/bq76952_TOP/BQ_ALERT: R40.2, U10.10 (INC), U14.25 (HDQ_IO/ALERT)
/bq76952_TOP/BQ_SCL: R38.1, U10.11 (SCL2), U14.26 (SCL/SPI_CLK)
/bq76952_TOP/BQ_SDA: R32.1, U10.14 (SDA2), U14.27 (SDA/SPI_MISO)
/bq76952_TOP/BQ_SHUT: R34.2, U10.13 (OUTA), U14.33 (RST_SHUT)
/bq76952_TOP/BQ_WAKE: U11.4, U14.22 (TS2/WAKE)
/bq76952_TOP/GNDS: C31.1, C33.2, C35.2, C36.2, C39.2, C43.2, C45.2, C47.2, C48.2, J7.2, J7.3, J10.1, R34.1, R35.2, R52.1, R53.1, R108.1, R183.2, U10.9 (GND2), U10.15 (GND2), U11.3, U14.17 (VSS), U14.29 (CFETOFF/SPI_CS), U14.30 (DFETOFF/BOTHOFF), U14.38 (FUSE), U14.41 (LD)
/bq76952_TOP/REG1: C31.2, C36.1, R32.2, R38.2, R40.1, U10.16 (VCC2), U14.35 (REG1)
/bq76952_TOP/SRN: R52.2, U14.20 (SRN)
/bq76952_TOP/SRP: R53.2, U14.18 (SRP)
/bq76952_TOP/c0: D21.2 (A), J10.11, Q13.2 (S), R74.1, R108.2
/bq76952_TOP/c1: D17.2 (A), J10.12, Q9.2 (S), R73.1, R129.1
/bq76952_TOP/c2: D13.2 (A), J10.2, Q5.2 (S), R72.1, R121.1
/bq76952_TOP/c3: D25.2 (A), J10.3, Q17.2 (S), R71.1, R113.1
/bq76952_TOP/c4: D29.2 (A), J10.14, Q21.2 (S), R70.1, R137.1
/bq76952_TOP/c5: D33.2 (A), J10.4, Q25.2 (S), R69.1, R145.1
/bq76952_TOP/c6: D37.2 (A), J10.15, Q29.2 (S), R68.1, R153.1
/bq76952_TOP/c7: D41.2 (A), J10.5, Q33.2 (S), R67.1, R99.1, R161.1
/bq76952_TOP/c8: D39.2 (A), J10.16, Q35.2 (S), R66.1, R98.1, R99.2, R169.1
/bq76952_TOP/c9: D35.2 (A), J10.6, Q31.2 (S), R65.1, R97.1, R98.2, R171.1
/bq76952_TOP/c10: D31.2 (A), J10.17, Q27.2 (S), R64.1, R96.1, R97.2, R163.1
/bq76952_TOP/c11: D23.2 (A), J10.7, Q19.2 (S), R63.1, R95.1, R96.2, R155.1
/bq76952_TOP/c12: D28.2 (A), J10.18, Q23.2 (S), R62.1, R94.1, R95.2, R139.1
/bq76952_TOP/c13: D11.2 (A), J10.8, Q7.2 (S), R61.1, R93.1, R94.2, R147.1
/bq76952_TOP/c14: D15.2 (A), J10.19, Q11.2 (S), R60.1, R92.1, R93.2, R115.1
/bq76952_TOP/c15: D19.2 (A), J10.9, Q15.2 (S), R59.1, R92.2, R123.1
/bq76952_TOP/c16: J10.20, R58.1, R131.1
/bq76952_TOP/top: D6.2 (A), D8.2 (A), J10.10, R44.2
/bq76952_TOP/vc0: C48.1, C65.2, R74.2, R127.2, U14.16 (VC0)
/bq76952_TOP/vc1: C47.1, C64.2, C65.1, R73.2, R119.2, U14.15 (VC1)
/bq76952_TOP/vc2: C63.2, C64.1, R72.2, R111.2, U14.14 (VC2)
/bq76952_TOP/vc3: C62.2, C63.1, R71.2, R135.2, U14.13 (VC3)
/bq76952_TOP/vc4: C61.2, C62.1, R70.2, R143.2, U14.12 (VC4)
/bq76952_TOP/vc5: C60.2, C61.1, R69.2, R151.2, U14.11 (VC5)
/bq76952_TOP/vc6: C59.2, C60.1, R68.2, R159.2, U14.10 (VC6)
/bq76952_TOP/vc7: C58.2, C59.1, R67.2, R167.2, U14.9 (VC7)
/bq76952_TOP/vc8: C57.2, C58.1, R66.2, R173.2, U14.8 (VC8)
/bq76952_TOP/vc9: C56.2, C57.1, R65.2, R165.2, U14.7 (VC9)
/bq76952_TOP/vc10: C55.2, C56.1, R64.2, R157.2, U14.6 (VC10)
/bq76952_TOP/vc11: C54.2, C55.1, R63.2, R141.2, U14.5 (VC11)
/bq76952_TOP/vc12: C53.2, C54.1, R62.2, R149.2, U14.4 (VC12)
/bq76952_TOP/vc13: C52.2, C53.1, R61.2, R117.2, U14.3 (VC13)
/bq76952_TOP/vc14: C51.2, C52.1, R60.2, R125.2, U14.2 (VC14)
/bq76952_TOP/vc15: C51.1, C81.2, R59.2, R133.2, U14.1 (VC15)
unnamed: C33.1, Q2.2 (C), Q2.4 (C), R42.1
unnamed: D6.1 (K), R42.2
unnamed: D8.1 (K), R56.1
unnamed: D11.1 (K), Q7.1 (G), R117.1
unnamed: D13.1 (K), Q5.1 (G), R111.1
unnamed: D15.1 (K), Q11.1 (G), R125.1
unnamed: D17.1 (K), Q9.1 (G), R119.1
unnamed: D19.1 (K), Q15.1 (G), R133.1
unnamed: D21.1 (K), Q13.1 (G), R127.1
unnamed: D23.1 (K), Q19.1 (G), R141.1
unnamed: D25.1 (K), Q17.1 (G), R135.1
unnamed: D28.1 (K), Q23.1 (G), R149.1
unnamed: D29.1 (K), Q21.1 (G), R143.1
unnamed: D31.1 (K), Q27.1 (G), R157.1
unnamed: D33.1 (K), Q25.1 (G), R151.1
unnamed: D35.1 (K), Q31.1 (G), R165.1
unnamed: D37.1 (K), Q29.1 (G), R159.1
unnamed: D39.1 (K), Q35.1 (G), R173.1
unnamed: D41.1 (K), Q33.1 (G), R167.1
unnamed: J7.1, U14.21 (TS1)
unnamed: J7.4, U14.23 (TS3)
unnamed: Q2.1 (B), R183.1, U14.37 (BREG)
unnamed: C35.1, Q2.3 (E), U14.36 (REGIN)
unnamed: Q5.3 (D), R113.2
unnamed: Q7.3 (D), R115.2
unnamed: Q9.3 (D), R121.2
unnamed: Q11.3 (D), R123.2
unnamed: Q13.3 (D), R129.2
unnamed: Q15.3 (D), R131.2
unnamed: Q17.3 (D), R137.2
unnamed: Q19.3 (D), R139.2
unnamed: Q21.3 (D), R145.2
unnamed: Q23.3 (D), R147.2
unnamed: Q25.3 (D), R153.2
unnamed: Q27.3 (D), R155.2
unnamed: Q29.3 (D), R161.2
unnamed: Q31.3 (D), R163.2
unnamed: Q33.3 (D), R169.2
unnamed: Q35.3 (D), R171.2
unnamed: R26.1, U11.1
unnamed: R44.1, R45.2
unnamed: C43.1, C45.1, R50.2, R56.2, U14.47 (BAT)
unnamed: R50.1, U14.46 (CP1)
unnamed: R35.1, U14.28 (HDQ_IO/SPI_MOSI)
unnamed: R45.1, U14.42 (PACK)
unnamed: C39.1, U14.24 (REG18)
unnamed: C81.1, R58.2, U14.48 (VC16)
