tamergrlli/32S_BMS/32s_bms/32s_bms.kicad_pcb

## KiCad design 32s_bms/32s_bms.kicad_pcb (continued)

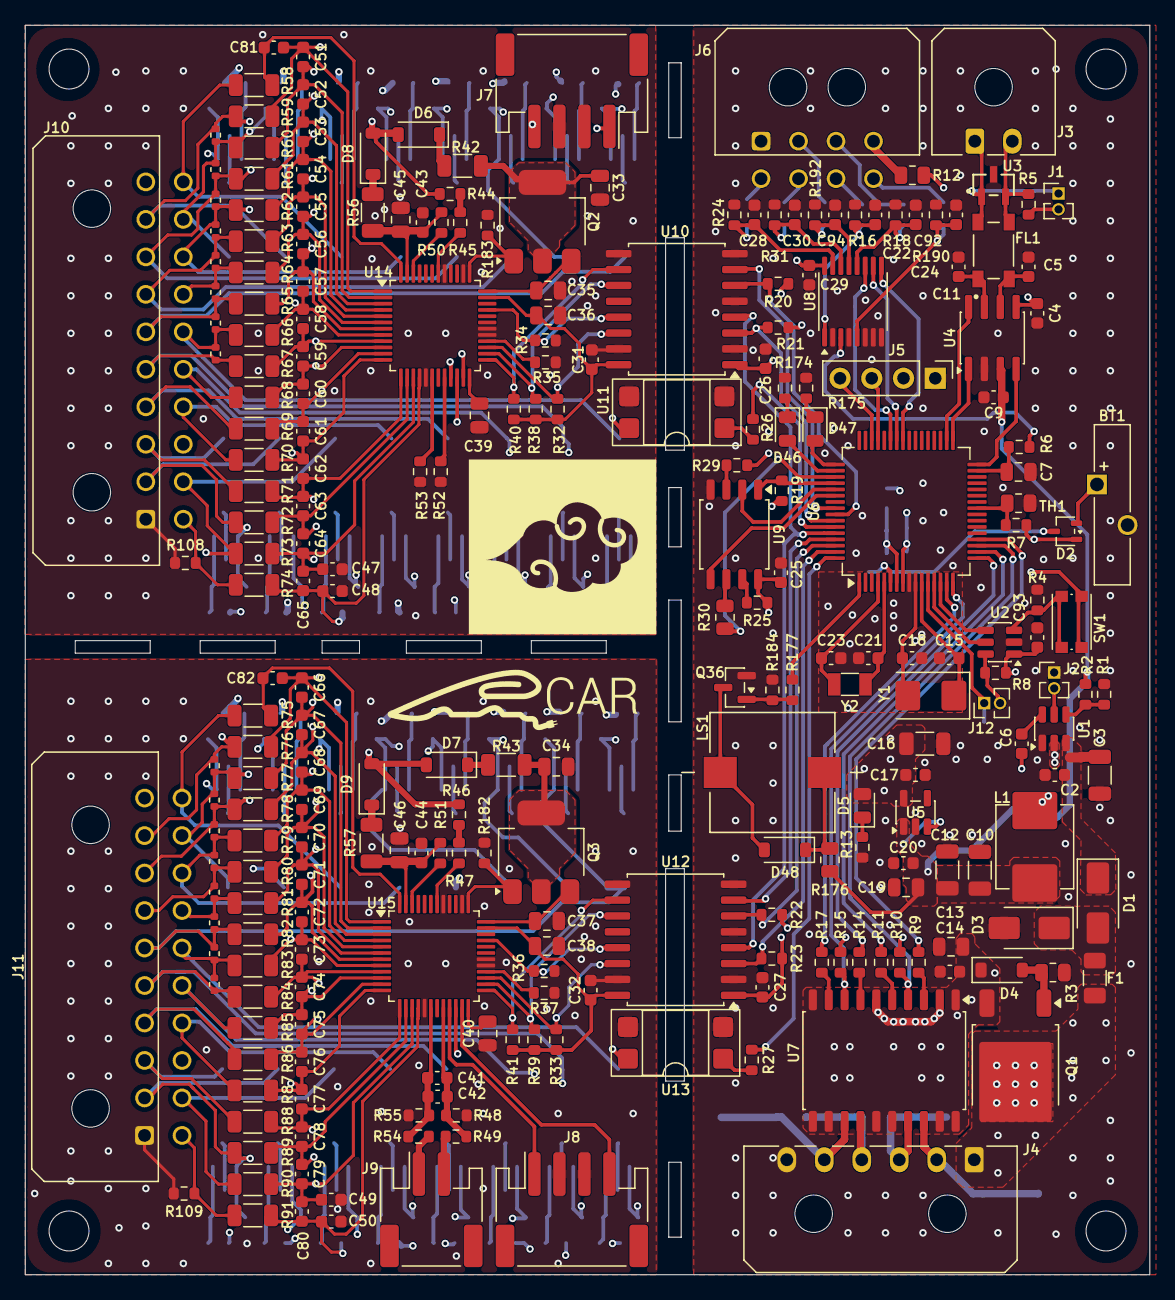
[picture p32: board 32s_bms.kicad_pcb from above]

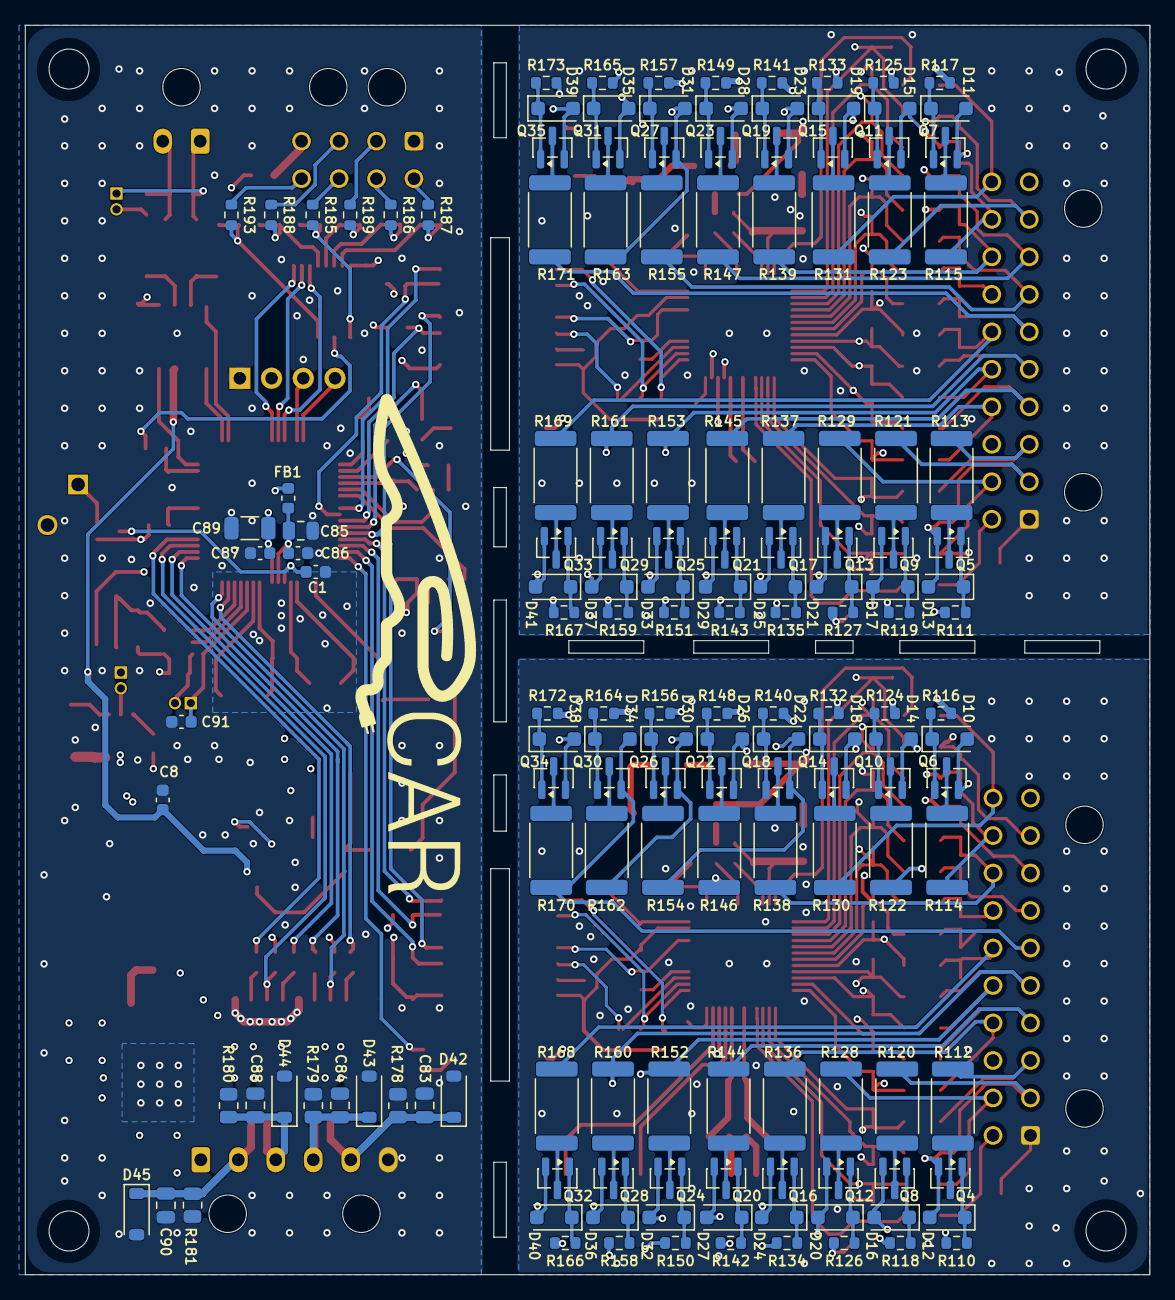
[picture p33: board 32s_bms.kicad_pcb from below]

Board: 4 copper layers, 90.0 x 100.0 mm, 410 parts (154 on the bottom side), 274 nets.
